xdylanm/state-variable-filter/README.md

# State Variable Filter

The state variable filter is a second order (12dB/oct) filter with low-, high- and band-pass outputs and adjustable resonance. This is a classic filter design that appears in a number of synths, including the Oberheim SEM.
