xdylanm/state-variable-filter/docs/assets/images/PN_filter_response.png

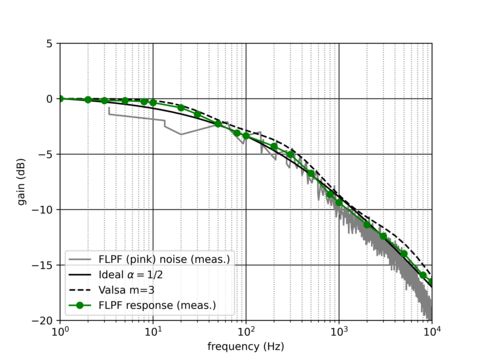
docs/assets/images/PN_filter_response.png
