xdylanm/state-variable-filter/docs/assets/images/svf-1-front-3d.png

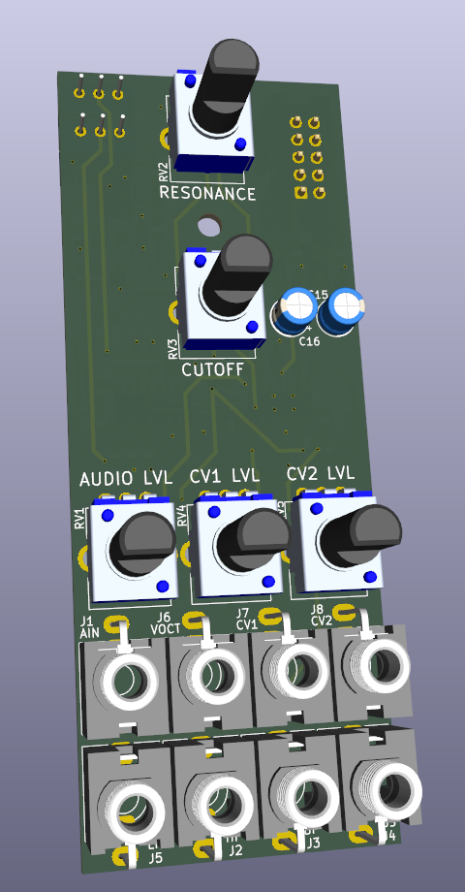
docs/assets/images/svf-1-front-3d.png
