xdylanm/state-variable-filter/docs/assets/svf-1.pdf

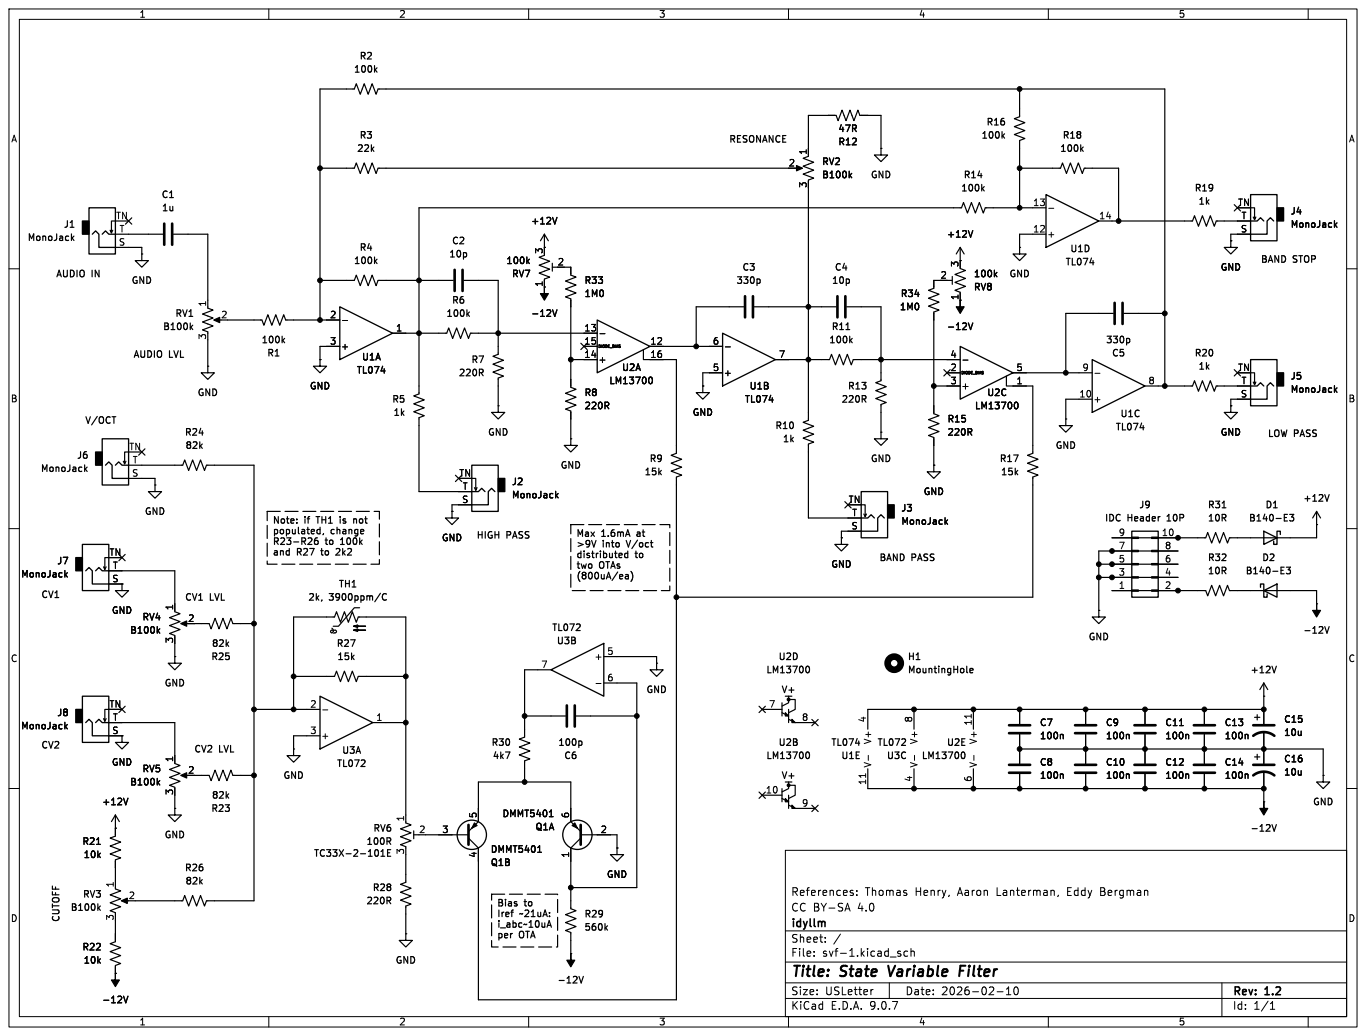
[picture p12: page 1]

idyllm
Id: 1/1 Title: State Variable Filter File: svf-1.kicad_sch Sheet: /
