xdylanm/state-variable-filter/hardware/svf-1/svf-1.kicad_pcb

## KiCad design hardware/svf-1/svf-1.kicad_pcb (2026-02-13)

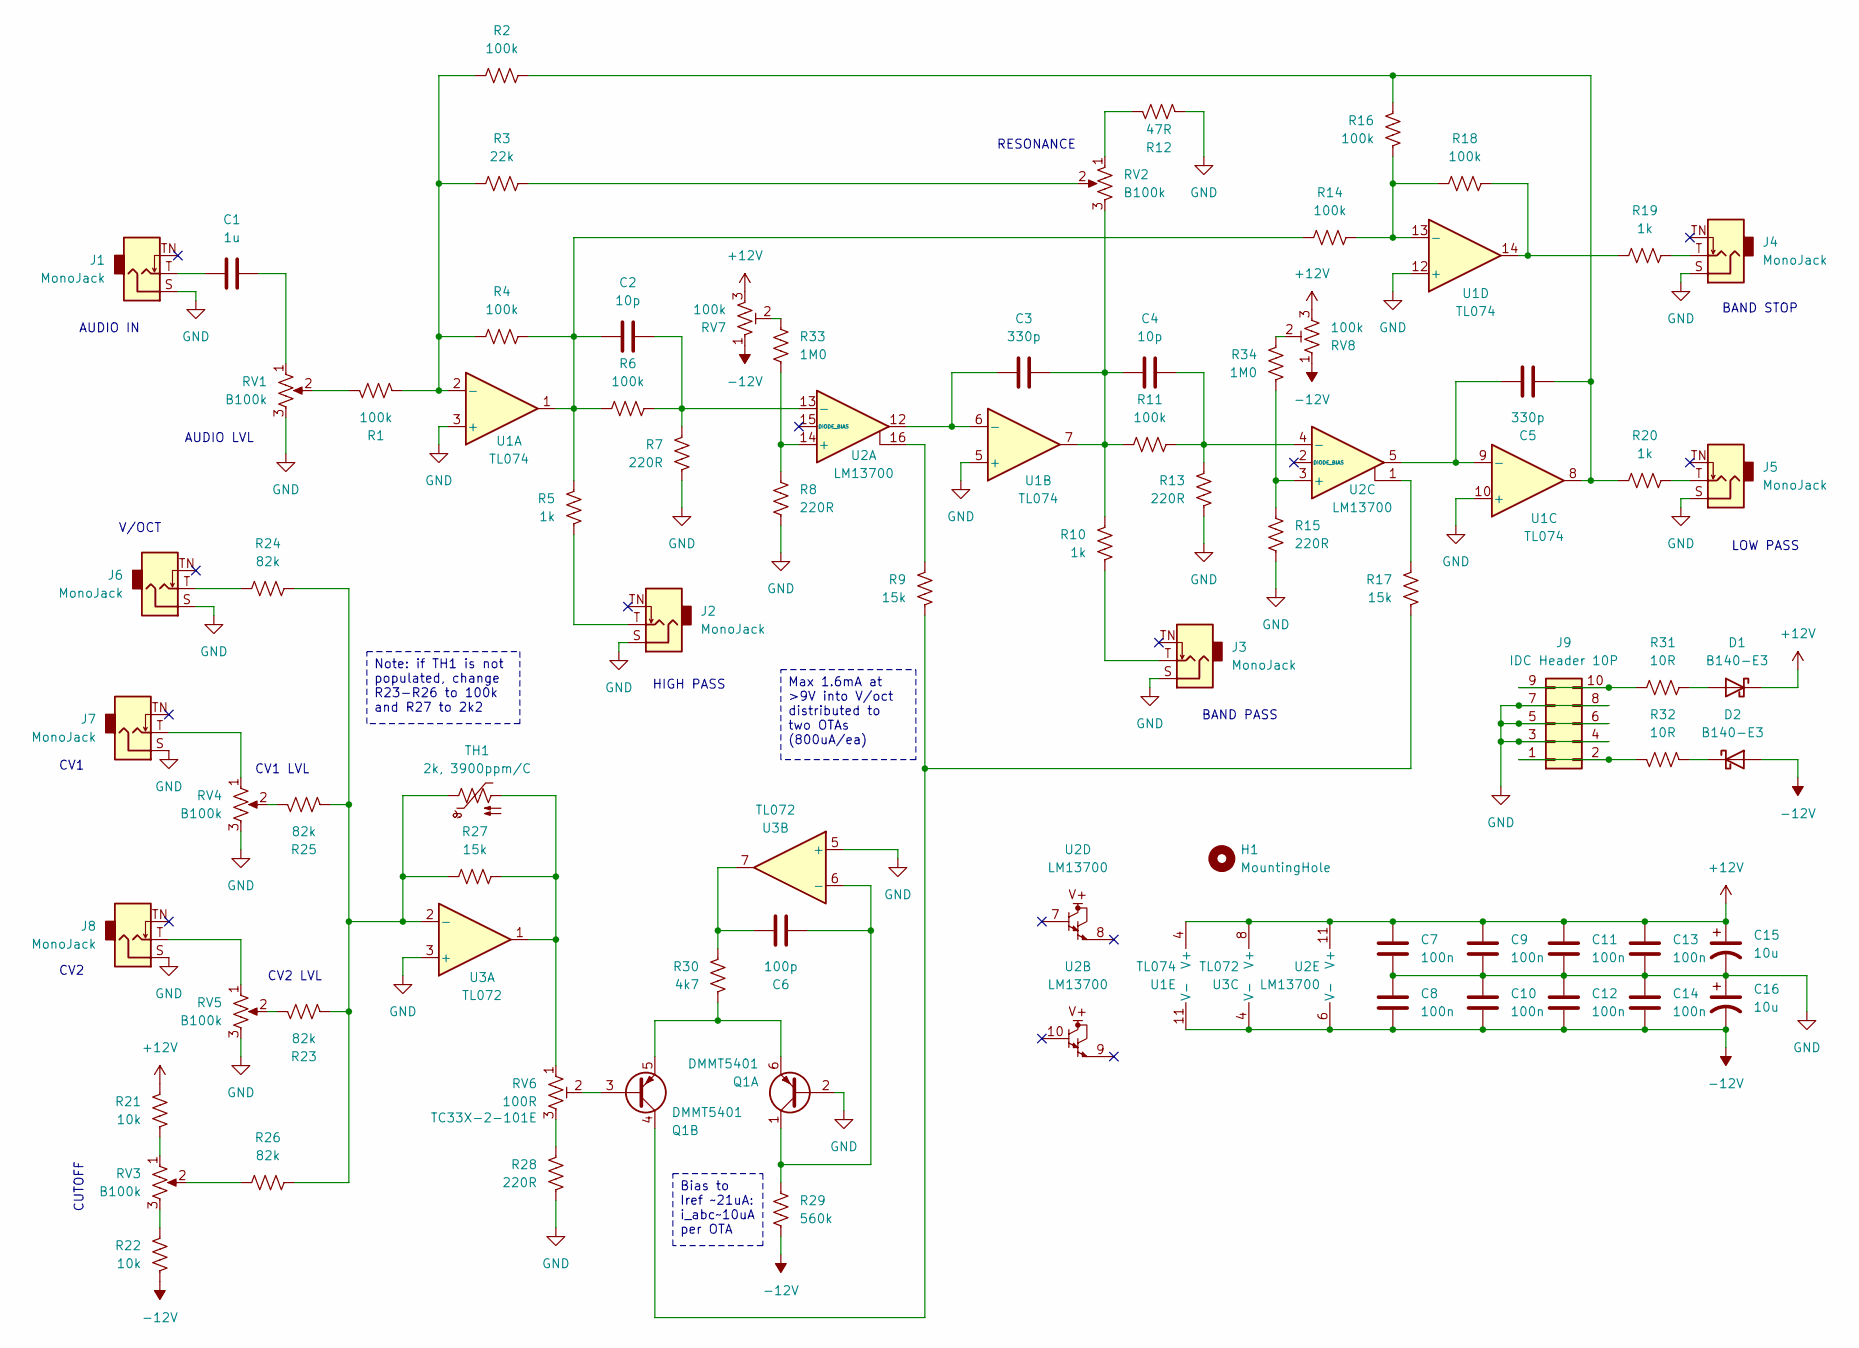
[picture p13: schematic svf-1.kicad_sch, State Variable Filter]

Parts:
C1: 1u; C_0805_2012Metric_Pad1.18x1.45mm_HandSolder
C2, C4: 10p; C_0805_2012Metric_Pad1.18x1.45mm_HandSolder
C3, C5: 330p; C_0805_2012Metric_Pad1.18x1.45mm_HandSolder
C6: 100p; C_0805_2012Metric_Pad1.18x1.45mm_HandSolder
C7, C8, C9, C10, C11, C12, C13, C14: 100n; C_0805_2012Metric_Pad1.18x1.45mm_HandSolder
C15, C16: 10u; CP_Radial_D5.0mm_P2.50mm
D1, D2: B140-E3; D_SMA
H1: MountingHole; MountingHole_3.2mm_M3_DIN965
J1, J2, J3, J4, J5, J6, J7, J8: MonoJack; Jack_3.5mm_QingPu_WQP-PJ301M-12_Vertical
J9: IDC Header 10P; IDC-Header_2x05_P2.54mm_Vertical
Q1: DMMT5401; SOT-23-6_Handsoldering
R1, R2, R4, R6, R11, R14, R16, R18: 100k; R_0805_2012Metric_Pad1.20x1.40mm_HandSolder
R3: 22k; R_0805_2012Metric_Pad1.20x1.40mm_HandSolder
R5, R10, R19, R20: 1k; R_0805_2012Metric_Pad1.20x1.40mm_HandSolder
R7, R8, R13, R15, R28: 220R; R_0805_2012Metric_Pad1.20x1.40mm_HandSolder
R9, R17, R27: 15k; R_0805_2012Metric_Pad1.20x1.40mm_HandSolder
R12: 47R; R_0805_2012Metric_Pad1.20x1.40mm_HandSolder
R21, R22: 10k; R_0805_2012Metric_Pad1.20x1.40mm_HandSolder
R23, R24, R25, R26: 82k; R_0805_2012Metric_Pad1.20x1.40mm_HandSolder
R29: 560k; R_0805_2012Metric_Pad1.20x1.40mm_HandSolder
R30: 4k7; R_0805_2012Metric_Pad1.20x1.40mm_HandSolder
R31, R32: 10R; R_0805_2012Metric_Pad1.20x1.40mm_HandSolder
R33, R34: 1M0; R_0805_2012Metric_Pad1.20x1.40mm_HandSolder
RV1, RV2, RV3, RV4, RV5: B100k; Potentiometer_Bourns_PTV09A-1_Single_Vertical_thin
RV6: 100R; Potentiometer_Bourns_TC33X_Vertical
RV7, RV8: 100k; Potentiometer_Bourns_3296W_Vertical
TH1: 2k, 3900ppm/C; R_0805_2012Metric_Pad1.20x1.40mm_HandSolder
U1: TL074; SOIC-14_3.9x8.7mm_P1.27mm
U2: LM13700; SOIC-16_3.9x9.9mm_P1.27mm
U3: TL072; SOIC-8_3.9x4.9mm_P1.27mm

Connections:
+12V: C7.1, C9.1, C11.1, C13.1, C15.1, D1.1 (K), R21.2, RV7.3, RV8.3, U1.4 (V+), U2.11 (V+), U3.8 (V+)
-12V: C8.2, C10.2, C12.2, C14.2, C16.2, D2.2 (A), R22.1, R29.1, RV7.1, RV8.1, U1.11 (V-), U2.6 (V-), U3.4 (V-)
GND: C7.2, C8.1, C9.2, C10.1, C11.2, C12.1, C13.2, C14.1, C15.2, C16.1, J1.S, J2.S, J3.S, J4.S, J5.S, J6.S, J7.S, J8.S, J9.3, J9.4, J9.5, J9.6, J9.7, J9.8, Q1.2 (B1), R7.1, R8.1, R12.2, R13.1, R15.1, R28.1, RV1.3, RV4.3, RV5.3, U1.3 (+), U1.5 (+), U1.10 (+), U1.12 (+), U3.3 (+), U3.5 (+)
unnamed: C1.1, RV1.1
unnamed: C1.2, J1.T
unnamed: C2.2, R4.2, R5.2, R6.1, R14.1, U1.1
unnamed: C3.1, C4.2, R10.2, R11.1, RV2.3, U1.7
unnamed: C5.1, R2.2, R16.2, R20.1, U1.8
unnamed: C6.2, R30.2, U3.7
unnamed: D1.2 (A), R31.2
unnamed: D2.1 (K), R32.2
unnamed: J2.T, R5.1
unnamed: J3.T, R10.1
unnamed: J4.T, R19.2
unnamed: J5.T, R20.2
unnamed: J6.T, R24.1
unnamed: J7.T, RV4.1
unnamed: J8.T, RV5.1
unnamed: J9.1, J9.2, R32.1
unnamed: J9.9, J9.10, R31.1
unnamed: C6.1, Q1.1 (C1), R29.2, U3.6 (-)
unnamed: Q1.5 (E2), Q1.6 (E1), R30.1
unnamed: Q1.3 (B2), RV6.2
unnamed: Q1.4 (C2), R9.1, R17.1
unnamed: R1.1, RV1.2
unnamed: R3.2, RV2.2
unnamed: R9.2, U2.16
unnamed: R12.1, RV2.1
unnamed: R17.2, U2.1
unnamed: R18.2, R19.1, U1.14
unnamed: R21.1, RV3.1
unnamed: R22.2, RV3.3
unnamed: R23.1, RV5.2
unnamed: R25.1, RV4.2
unnamed: R26.1, RV3.2
unnamed: R27.2, RV6.1, TH1.2, U3.1
unnamed: R28.2, RV6.3
unnamed: R33.2, RV7.2
unnamed: R34.2, RV8.2
unnamed: R1.2, R2.1, R3.1, R4.1, U1.2 (-)
unnamed: C3.2, U1.6 (-), U2.12
unnamed: C5.2, U1.9 (-), U2.5
unnamed: R14.2, R16.1, R18.1, U1.13 (-)
unnamed: R8.2, R33.1, U2.14 (+)
unnamed: C2.1, R6.2, R7.2, U2.13 (-)
unnamed: R15.2, R34.1, U2.3 (+)
unnamed: C4.1, R11.2, R13.2, U2.4 (-)
unnamed: R23.2, R24.2, R25.2, R26.2, R27.1, TH1.1, U3.2 (-)

Notes on the sheet:
RESONANCE
CV2 LVL
BAND PASS
CV1 LVL
AUDIO IN
HIGH PASS
BAND STOP
V/OCT
LOW PASS
CUTOFF
CV1
CV2
AUDIO LVL
Max 1.6mA at >9V into V/oct distributed to two OTAs (800uA/ea)
Note: if TH1 is not populated, change R23-R26 to 100k and R27 to 2k2
Bias to Iref ~21uA: i_abc~10uA per OTA

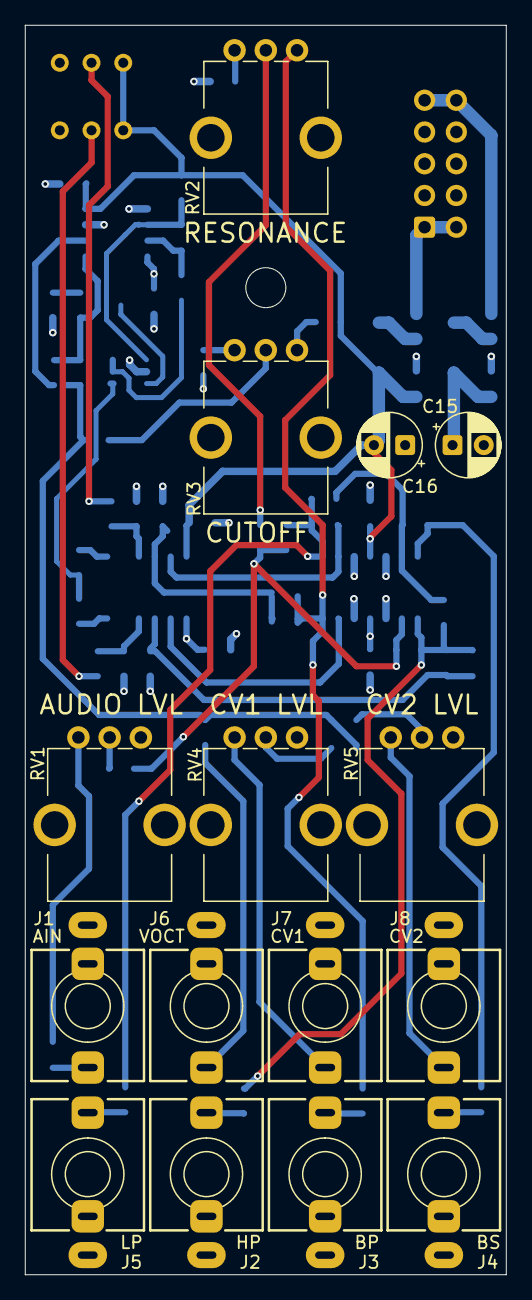
[picture p14: board svf-1.kicad_pcb from above]

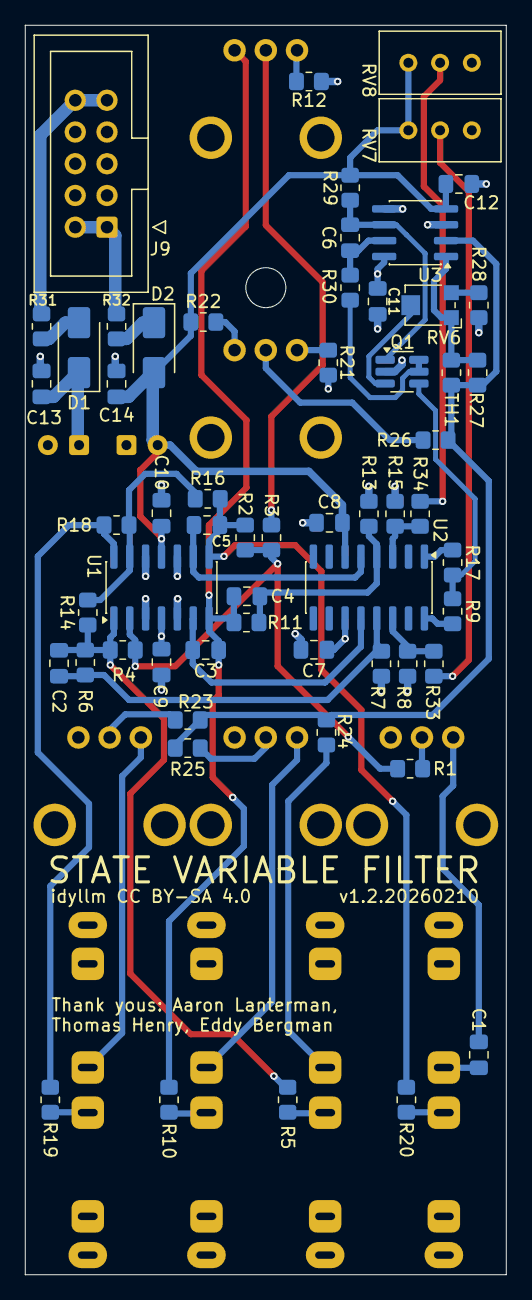
[picture p15: board svf-1.kicad_pcb from below]

Board: 4 copper layers, 38.5 x 100.0 mm, 75 parts (59 on the bottom side), 48 nets.
