xdylanm/state-variable-filter/(commit log)

2025-12-14 Initial version of the SVF with docs. Design to gerbers for PCB and verified on breadboard.
    [svf-1.kicad_pcb, svf-1.kicad_sch]
2025-12-15 Documentation update with 3D renders (added 3D models to footprints for pots)
    [svf-1.kicad_pcb]
2025-12-28 Schematic and PBC fix: replace incorrect MMDT5401 (SOT-363) with DMMT5401 (SOT-236) part
    [bom.csv, svf-1.kicad_pcb, svf-1.kicad_sch]
2026-01-02 Updated docs and design after building and testing the PCB
    [bom.csv, svf-1.kicad_pcb, svf-1.kicad_sch]
2026-01-03 Fix CV input pots and Rs
    [svf-1.kicad_pcb, svf-1.kicad_sch]
2026-02-13 Fix pnp wiring (#2)
    * Fix for flipped PNP wiring
    * Updated docs for fix
    [svf-1.kicad_pcb, svf-1.kicad_sch]
2026-02-13 Add faceplate (#3)
    * Added faceplate and updated docs
    * Added images
    [svf-1-faceplate.kicad_pcb, svf-1-faceplate.kicad_sch]
