xdylanm/state-variable-filter/(notices)

Notices in the files:
hardware/svf-1/svf-1.kicad_sch:
CC BY-SA 4.0
hardware/svf-1/svf-1.kicad_pcb:
idyllm CC BY-SA 4.0
